KuboPl240/GSM-alarm/alarm.brd

## EAGLE design alarm.brd (2026-11-08)

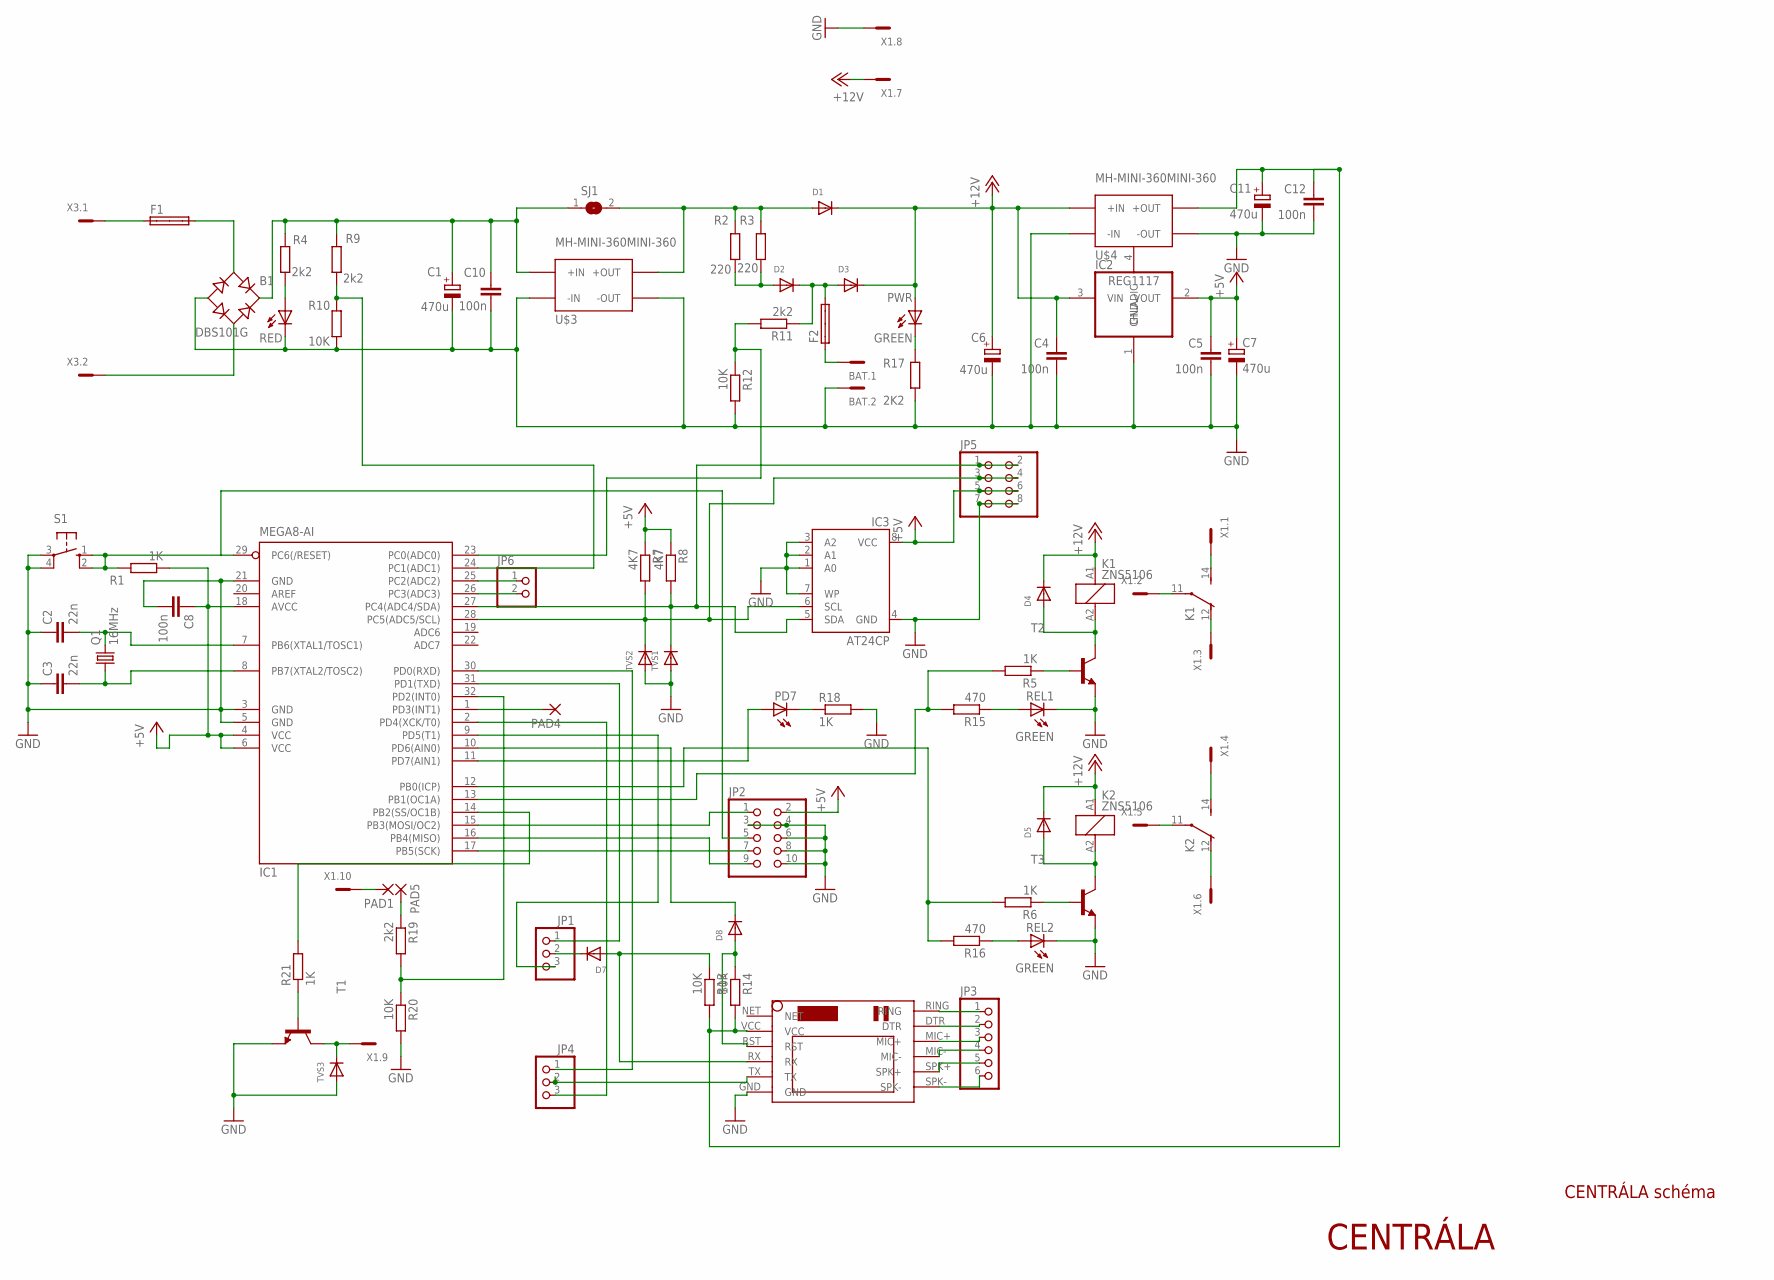
[picture p21: schematic alarm.sch]

Parts:
B1: DBS101G; DBS
BAT: MCV2
C1, C6, C7, C11: 470u; 153CLV-0810
C2, C3: 22n; C0805
C4, C5, C8, C10, C12: 100n; C0805
D1, D2, D3, D4, D5, D7, D8: DIODE_SOD-123FL; SOD-123FL
F1, F2: SHK20L
IC1: MEGA8-AI; TQFP32-08
IC2: REG1117; SOT223
IC3: AT24CP; DIL08
JP1, JP4: PINHD-1X3; 1X03
JP2: PINHD-2X5; 2X05
JP3: PINHD-1X6; 1X06
JP5: PINHD-2X4; 2X04
JP6: PINHD-1X2; 1X02
K1, K2: ZNS5106; ZN5
PAD1, PAD4, PAD5: 2,54/0,8
PD7: LEDCHIPLED_0805; CHIPLED_0805
PWR: GREEN; CHIPLED_0805
Q1: 16MHz; HC49UP
R1, R5, R6, R18, R21: 1K; R0805
R2, R3: 220; R1210
R4, R9, R11, R19: 2k2; R0805
R7, R8: 4K7; R0805
R10, R12, R13, R14, R20: 10K; R0805
R15, R16: 470; R0805
R17: 2K2; R0805
REL1, REL2: GREEN; CHIPLED_0805
S1: 10-XX; B3F-10XX
SJ1: SJW
SUPPLY: RED; CHIPLED_0805
T1, T2, T3: BC808-NPN-SOT23-BEC; SOT23-BEC
TVS1, TVS2, TVS3: DIODE_SOD-123FL; SOD-123FL
U$1: SIM800LMODULE
U$3, U$4: MH-MINI-360MINI-360; MH-MINI-360
X1: MCV10
X3: MCV2

Connections:
+4.4V: C11.+, C12.2, R13.2, R14.2, U$1.VCC, U$4.P$3 (+OUT)
+5V: C5.2, C7.+, C8.1, IC1.4 (VCC), IC1.6 (VCC), IC1.18 (AVCC), IC2.2 (VOUT), IC3.8 (VCC), JP2.2, JP5.5, JP5.6, R1.1, R7.1, R8.1
+12V: C4.2, C6.+, D1.C, D3.C, D4.C, D5.C, IC2.3 (VIN), K1.A1 (1), K2.A1 (1), PWR.A, U$4.P$2 (+IN), X1.7
CHLADIC: IC2.4 (CHLADIC)
GND: B1.-, BAT.2, C1.-, C2.1, C3.1, C4.1, C5.1, C6.-, C7.-, C8.2, C10.1, C11.-, C12.1, IC1.3 (GND), IC1.5 (GND), IC1.21 (GND), IC2.1 (GND), IC3.1 (A0), IC3.2 (A1), IC3.3 (A2), IC3.4 (GND), IC3.7 (WP), JP2.3, JP2.4, JP2.6, JP2.8, JP2.10, JP5.7, JP5.8, R10.2, R12.2, R17.2, R18.2, R20.2, REL1.C, REL2.C, S1.3, S1.4 (P1), SUPPLY.C, T1.E, T2.E, T3.E, TVS1.A, TVS2.A, TVS3.A, U$1.GND, U$3.P$1 (-IN), U$3.P$4 (-OUT), U$4.P$1 (-IN), U$4.P$4 (-OUT), X1.8
unnamed: B1.AC1, F1.2A
unnamed: B1.AC2, X3.2
unnamed: B1.+, C1.+, C10.2, R4.1, R9.1, SJ1.1, U$3.P$2 (+IN)
unnamed: JP3.6, U$1.SPK-
unnamed: D1.A, R2.2, R3.2, SJ1.2, U$3.P$3 (+OUT)
unnamed: D2.A, R2.1, R3.1
unnamed: D2.C, D3.A, F2.2A, R11.1
unnamed: BAT.1, F2.1A
unnamed: C3.2, IC1.8 (PB7(XTAL2/TOSC2)), Q1.1
unnamed: F1.1A, X3.1
unnamed: IC1.15 (PB3(MOSI/OC2)), JP2.1
unnamed: C2.2, IC1.7 (PB6(XTAL1/TOSC1)), Q1.2
unnamed: IC1.17 (PB5(SCK)), JP2.7
unnamed: R4.2, SUPPLY.A
unnamed: IC1.29 (PC6(/RESET)), JP2.5, R1.2, S1.1 (S), S1.2 (S1)
unnamed: IC1.16 (PB4(MISO)), JP2.9
unnamed: IC1.28 (PC5(ADC5/SCL)), IC3.6 (SCL), JP5.3, JP5.4, R7.2, TVS2.C
unnamed: PAD1.1, X1.10
unnamed: IC1.24 (PC1(ADC1)), R9.2, R10.1
unnamed: D5.A, K2.A2 (2), T3.C
unnamed: D4.A, K1.A2 (2), T2.C
unnamed: R5.1, T2.B
unnamed: R6.1, T3.B
unnamed: IC1.13 (PB1(OC1A)), R5.2, R15.2
unnamed: K1.14 (S), X1.1
unnamed: K1.11, X1.2
unnamed: K1.12 (O), X1.3
unnamed: K2.14 (S), X1.4
unnamed: K2.11, X1.5
unnamed: K2.12 (O), X1.6
unnamed: IC1.23 (PC0(ADC0)), R11.2, R12.1
unnamed: JP3.5, U$1.SPK+
unnamed: JP3.4, U$1.MIC-
unnamed: JP3.3, U$1.MIC+
unnamed: JP3.2, U$1.DTR
unnamed: JP3.1, U$1.RING
unnamed: JP4.2, U$1.TX
unnamed: D7.A, R13.1, U$1.RX
unnamed: IC1.31 (PD1(TXD)), JP1.1
unnamed: IC1.30 (PD0(RXD)), JP4.1
unnamed: IC1.2 (PD4(XCK/T0)), JP4.3
unnamed: D7.C, JP1.2
unnamed: IC1.9 (PD5(T1)), JP1.3
unnamed: D8.A, R14.1, U$1.RST
unnamed: R16.1, REL2.A
unnamed: D8.C, IC1.10 (PD6(AIN0))
unnamed: R15.1, REL1.A
unnamed: PWR.C, R17.1
unnamed: PD7.C, R18.1
unnamed: IC1.11 (PD7(AIN1)), PD7.A
unnamed: IC1.27 (PC4(ADC4/SDA)), IC3.5 (SDA), JP5.1, JP5.2, R8.2, TVS1.C
unnamed: IC1.32 (PD2(INT0)), R19.2, R20.1
unnamed: IC1.14 (PB2(SS/OC1B)), R21.2
unnamed: IC1.25 (PC2(ADC2)), JP6.1
unnamed: IC1.26 (PC3(ADC3)), JP6.2
unnamed: IC1.1 (PD3(INT1)), PAD4.1
unnamed: R21.1, T1.B
unnamed: T1.C, TVS3.C, X1.9
unnamed: PAD5.1, R19.1
unnamed: IC1.12 (PB0(ICP)), R6.2, R16.2

Notes on the sheet:
CENTRÁLA
CENTRÁLA schéma

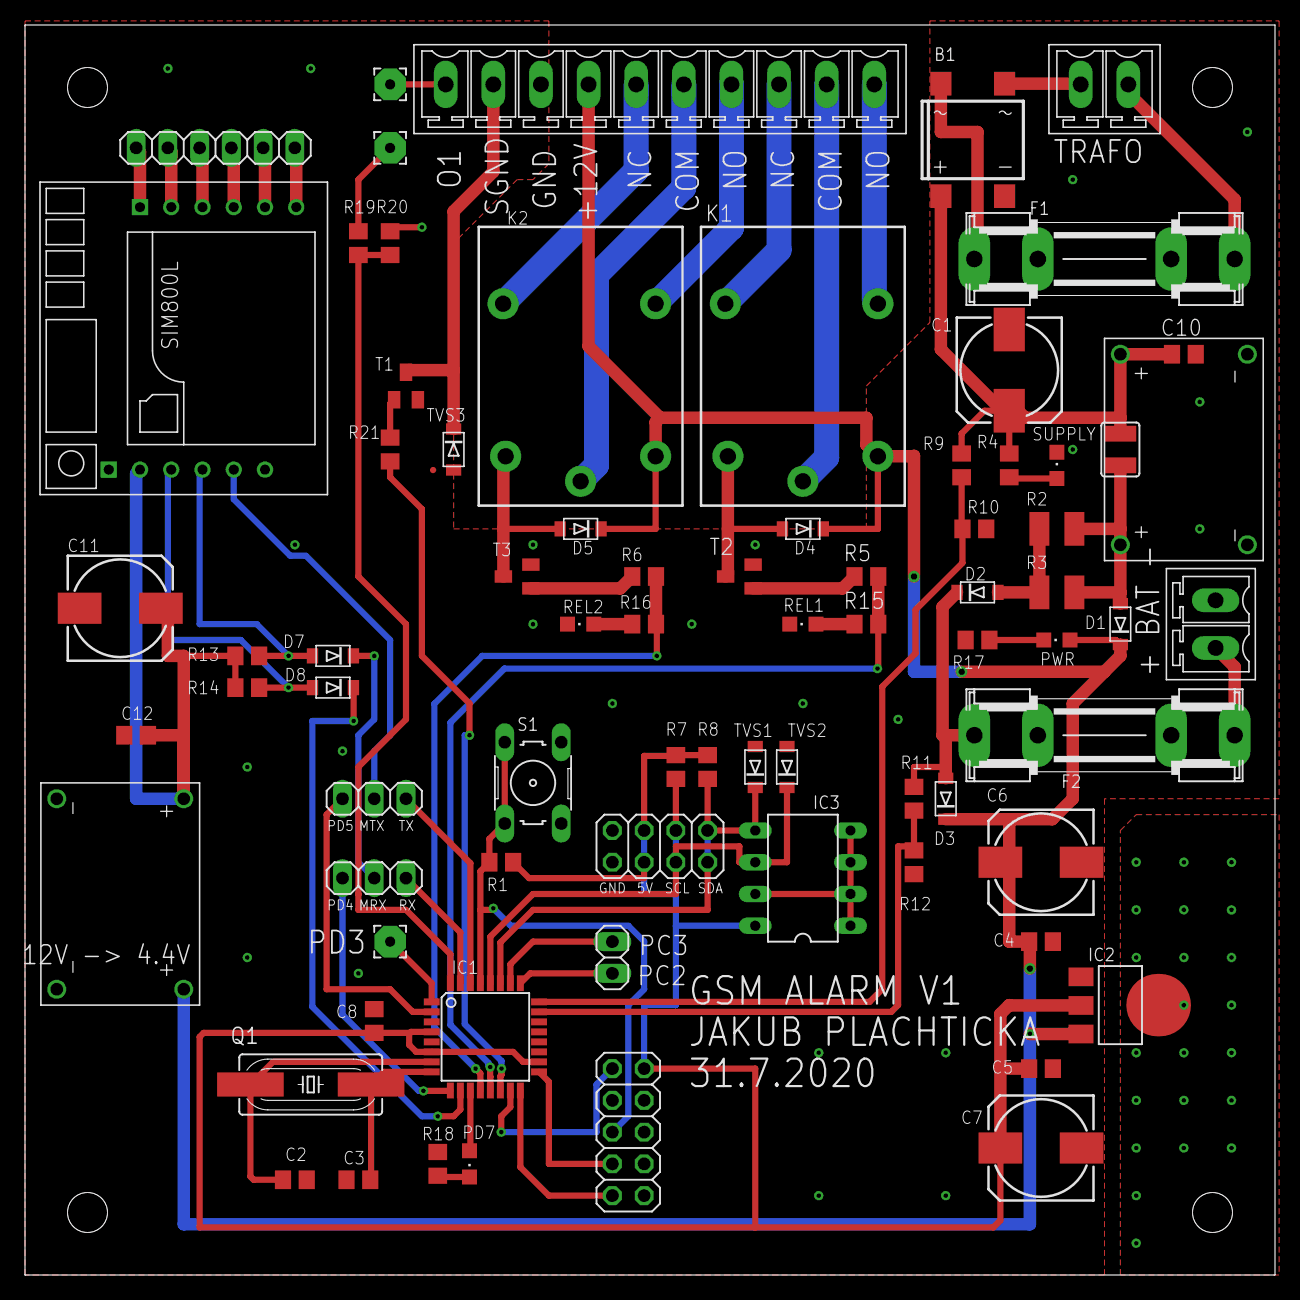
[picture p22: board alarm.brd from above]

Board: 2 copper layers, 100.0 x 100.0 mm, 76 parts (0 on the bottom side), 64 nets.
