KuboPl240/GSM-alarm/klavesnica.brd

## EAGLE design klavesnica.brd (2026-11-08)

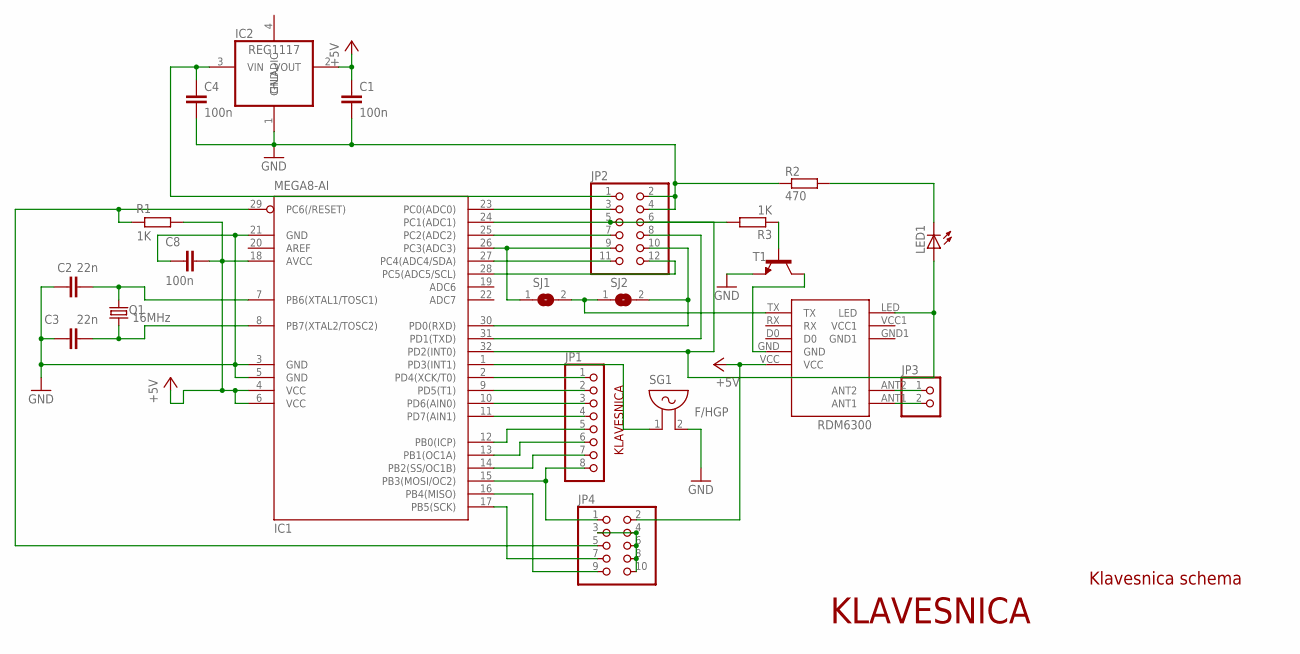
[picture p23: schematic klavesnica.sch]

Parts:
C1, C4, C8: 100n; C0805
C2, C3: 22n; C0805
IC1: MEGA8-AI; TQFP32-08
IC2: REG1117; SOT223
JP1: PINHD-1X8; 1X08
JP2: PINHD-2X6; 2X06
JP3: PINHD-1X2; 1X02
JP4: PINHD-2X5; 2X05
LED1: LED3MM
Q1: 16MHz; HC49UP
R1, R3: 1K; R0805
R2: 470; R0805
RDM1: RDM6300
SG1: F/HGP
SJ1, SJ2: SJ
T1: BC808-NPN-SOT23-BEC; SOT23-BEC

Connections:
+5V: C1.1, C8.1, IC1.4 (VCC), IC1.6 (VCC), IC1.18 (AVCC), IC2.2 (VOUT), JP4.2, R1.1, RDM1.VCC
CHLADIC: IC2.4 (CHLADIC)
GND: C1.2, C2.1, C3.1, C4.2, C8.2, IC1.3 (GND), IC1.5 (GND), IC1.21 (GND), IC2.1 (GND), JP2.2, JP2.4, R2.1, SG1.2, T1.E
unnamed: IC1.29 (PC6(/RESET)), JP4.5, R1.2
unnamed: IC1.2 (PD4(XCK/T0)), JP1.1
unnamed: IC1.9 (PD5(T1)), JP1.2
unnamed: IC1.10 (PD6(AIN0)), JP1.3
unnamed: IC1.11 (PD7(AIN1)), JP1.4
unnamed: IC1.12 (PB0(ICP)), JP1.5
unnamed: IC1.13 (PB1(OC1A)), JP1.6
unnamed: IC1.14 (PB2(SS/OC1B)), JP1.7
unnamed: C3.2, IC1.8 (PB7(XTAL2/TOSC2)), Q1.1
unnamed: C4.1, IC2.3 (VIN), JP2.1
unnamed: LED1.K (C), R2.2
unnamed: C2.2, IC1.7 (PB6(XTAL1/TOSC1)), Q1.2
unnamed: IC1.23 (PC0(ADC0)), JP2.3
unnamed: IC1.24 (PC1(ADC1)), JP2.5, R3.2
unnamed: IC1.25 (PC2(ADC2)), JP2.7
unnamed: IC1.26 (PC3(ADC3)), JP2.9, SJ1.1
unnamed: IC1.27 (PC4(ADC4/SDA)), JP2.11
unnamed: IC1.28 (PC5(ADC5/SCL)), JP2.12
unnamed: IC1.30 (PD0(RXD)), JP2.10, SJ2.2
unnamed: IC1.31 (PD1(TXD)), JP2.8
unnamed: IC1.1 (PD3(INT1)), SG1.1
unnamed: JP3.1, RDM1.ANT2
unnamed: JP3.2, RDM1.ANT1
unnamed: JP4.3, JP4.4, JP4.6, JP4.8, JP4.10
unnamed: IC1.32 (PD2(INT0)), JP2.6, LED1.A, RDM1.LED
unnamed: IC1.16 (PB4(MISO)), JP4.9
unnamed: IC1.17 (PB5(SCK)), JP4.7
unnamed: RDM1.GND, T1.C
unnamed: IC1.15 (PB3(MOSI/OC2)), JP1.8, JP4.1
unnamed: R3.1, T1.B
unnamed: RDM1.TX, SJ1.2, SJ2.1

Notes on the sheet:
KLAVESNICA
Klavesnica schema

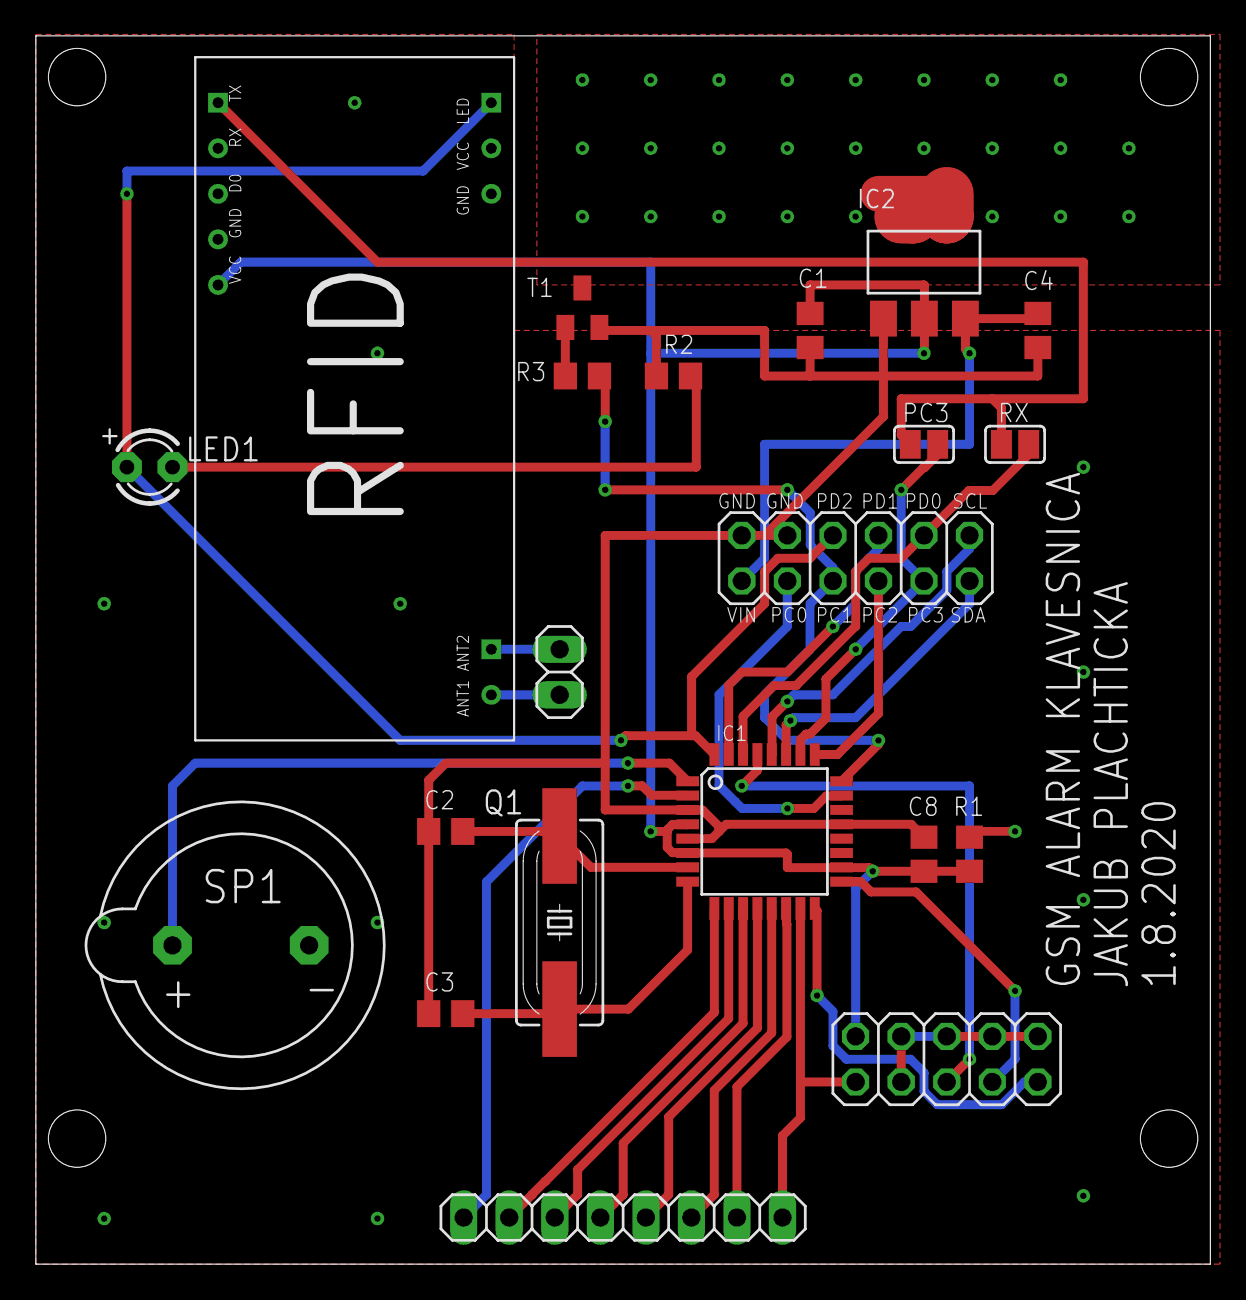
[picture p24: board klavesnica.brd from above]

Board: 2 copper layers, 65.5 x 68.5 mm, 21 parts (0 on the bottom side), 33 nets.
